NikolaiSte/CaNoRock/CaNoRock19 - English/Other documents/placement_and_orientation.jpg

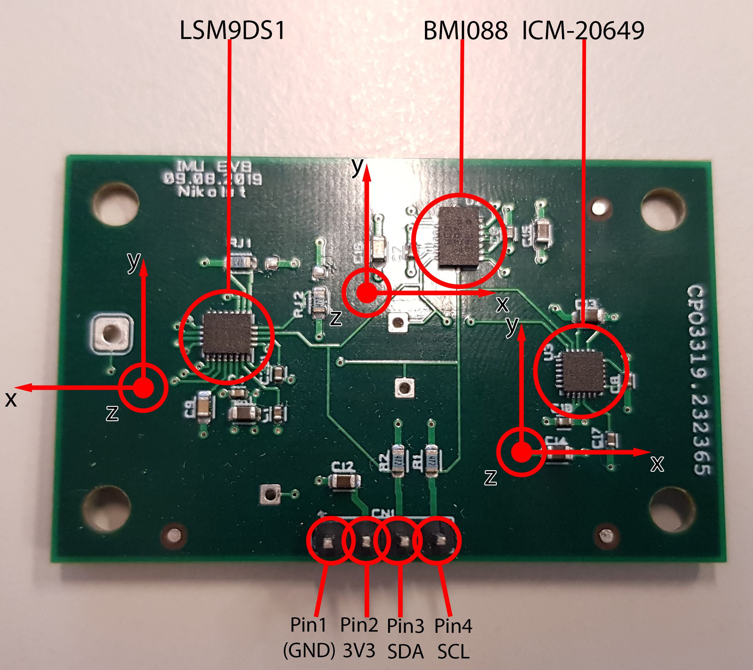
CaNoRock19 - English/Other documents/placement_and_orientation.jpg
