NikolaiSte/CaNoRock/CaNoRock19 - English/Arduino library files/README.txt

These folders need to be added to the correct folder in windows. If you have a general install of arduino, this would be
	C:\Users\xxxx\Documents\Arduino\libraries

This is because the header-files and their accompanying c++ files describing the function of each sensor are slightly modified
for the PCB-layout.
