NikolaiSte/CaNoRock/CaNoRock19 - English/Arduino library files/ICM20649/readme.md

# InvenSense 6-axis Accelerometer and Gyroscope(ICM20649)

## Usage
```
1. Git clone this repository to your Arduino IDE's libraries directory.
2. Run the demo "icm20649_example" in the examples directory.
```

This software is written by Ketil Røed and is licensed under [The MIT License](http://opensource.org/licenses/mit-license.php)

## Features

## Resources

- [Datasheet](http://www.invensense.com/wp-content/uploads/2016/06/DS-000192-ICM-20649-v1.0.pdf)
- [Evaluation board](https://no.mouser.com/datasheet/2/400/AN-IVS-0001EVB-00%20v1%202-1112214.pdf)
