NikolaiSte/CaNoRock/MainTM/Acceleration_X_MainTM.png

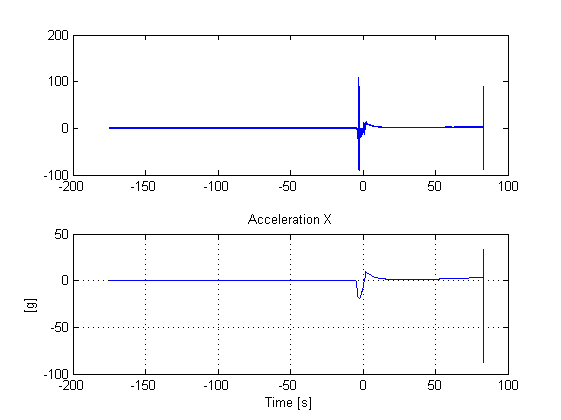
MainTM/Acceleration_X_MainTM.png
