NikolaiSte/CaNoRock/MainTM/Acceleration_Y_MainTM.png

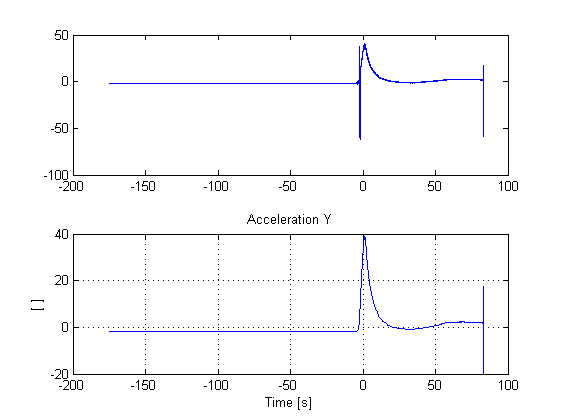
MainTM/Acceleration_Y_MainTM.png
