NikolaiSte/CaNoRock/MainTM/Battery_Voltage_MainTM.png

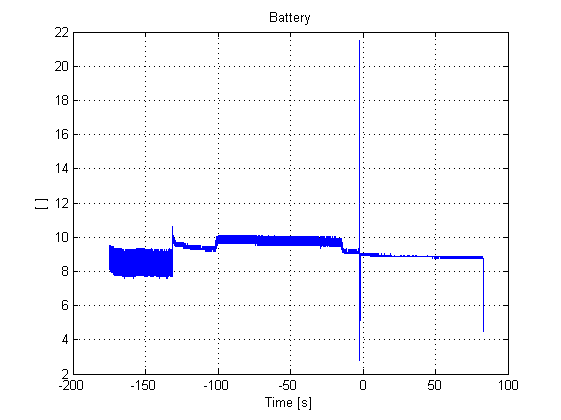
MainTM/Battery_Voltage_MainTM.png
