NikolaiSte/CaNoRock/MainTM/External_Temperature_MainTM.png

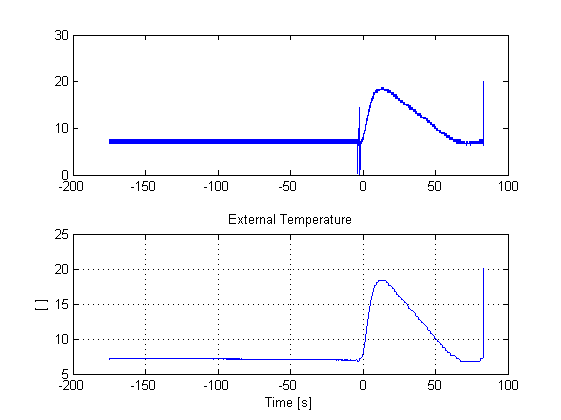
MainTM/External_Temperature_MainTM.png
