NikolaiSte/CaNoRock/MainTM/Framecounter_MainTM.png

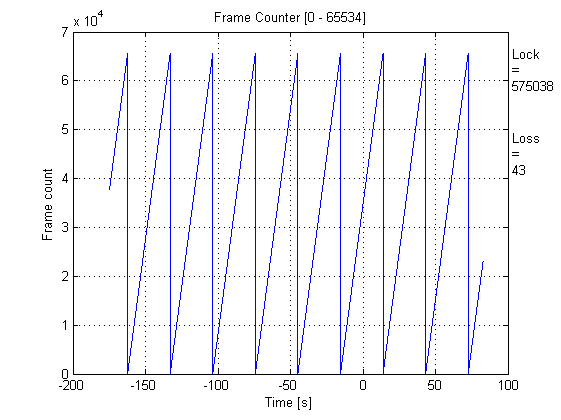
MainTM/Framecounter_MainTM.png
