NikolaiSte/CaNoRock/MainTM/Internal_Temperature_MainTM.png

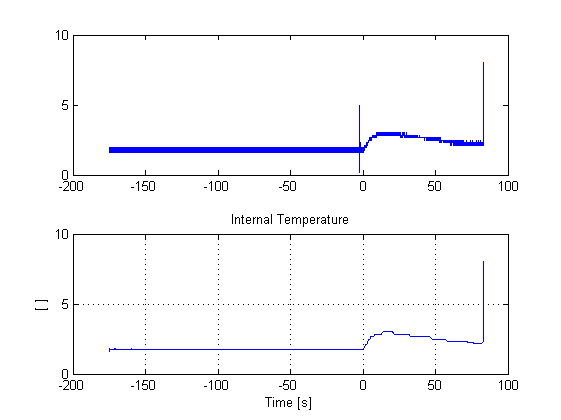
MainTM/Internal_Temperature_MainTM.png
