NikolaiSte/CaNoRock/MainTM/Light_MainTM.png

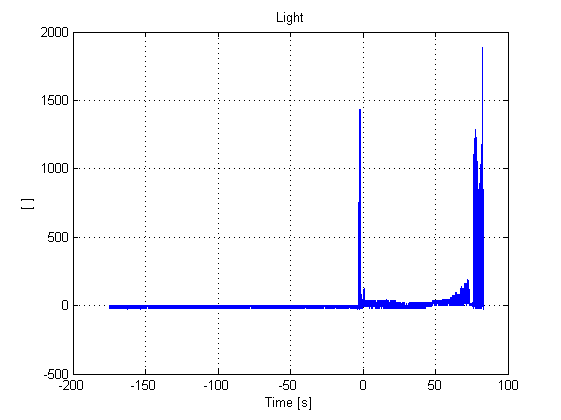
MainTM/Light_MainTM.png
