NikolaiSte/CaNoRock/MainTM/Magnetic_Field_MainTM.png

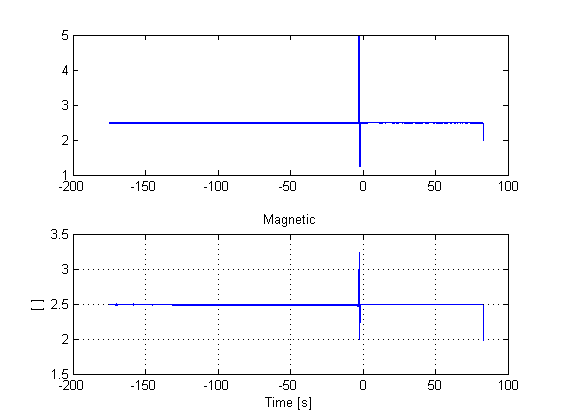
MainTM/Magnetic_Field_MainTM.png
