NikolaiSte/CaNoRock/MainTM/Pressure_MainTM.png

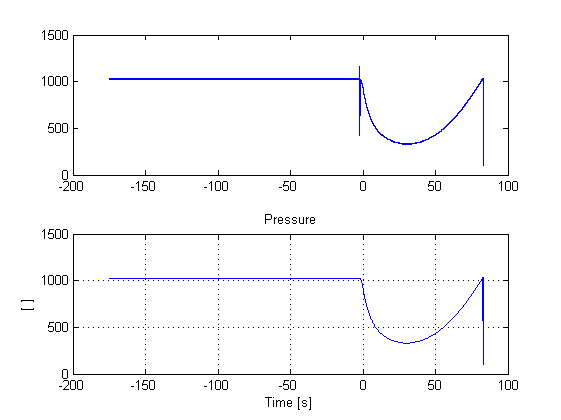
MainTM/Pressure_MainTM.png
