NikolaiSte/CaNoRock/MainTM/Temperature_Array_MainTM.png

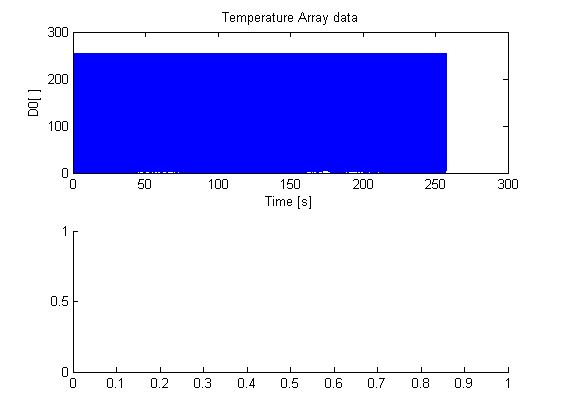
MainTM/Temperature_Array_MainTM.png
