NikolaiSte/CaNoRock/CaNoRock19 - English/Other documents/CAD-files/EVB_v1_6_fin_top_assembly.pdf

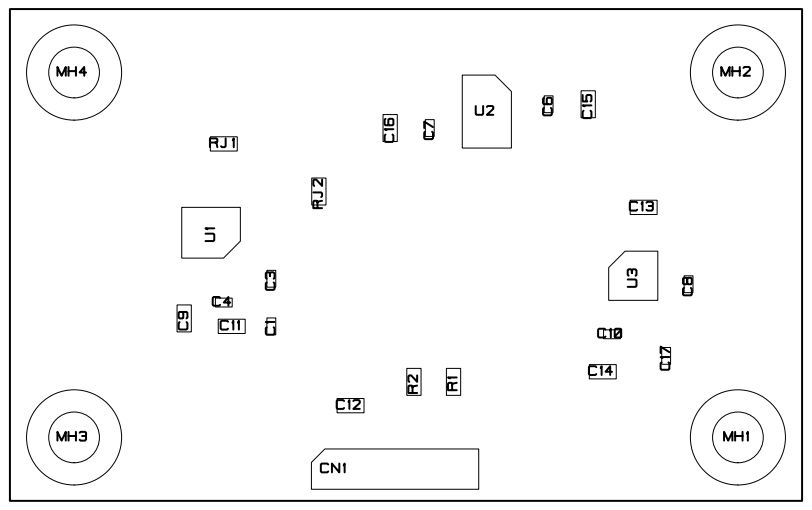
[picture p39: page 1]
