NikolaiSte/CaNoRock/CaNoRock19 - English/Other documents/CAD-files/EVB_sch_v1.pdf

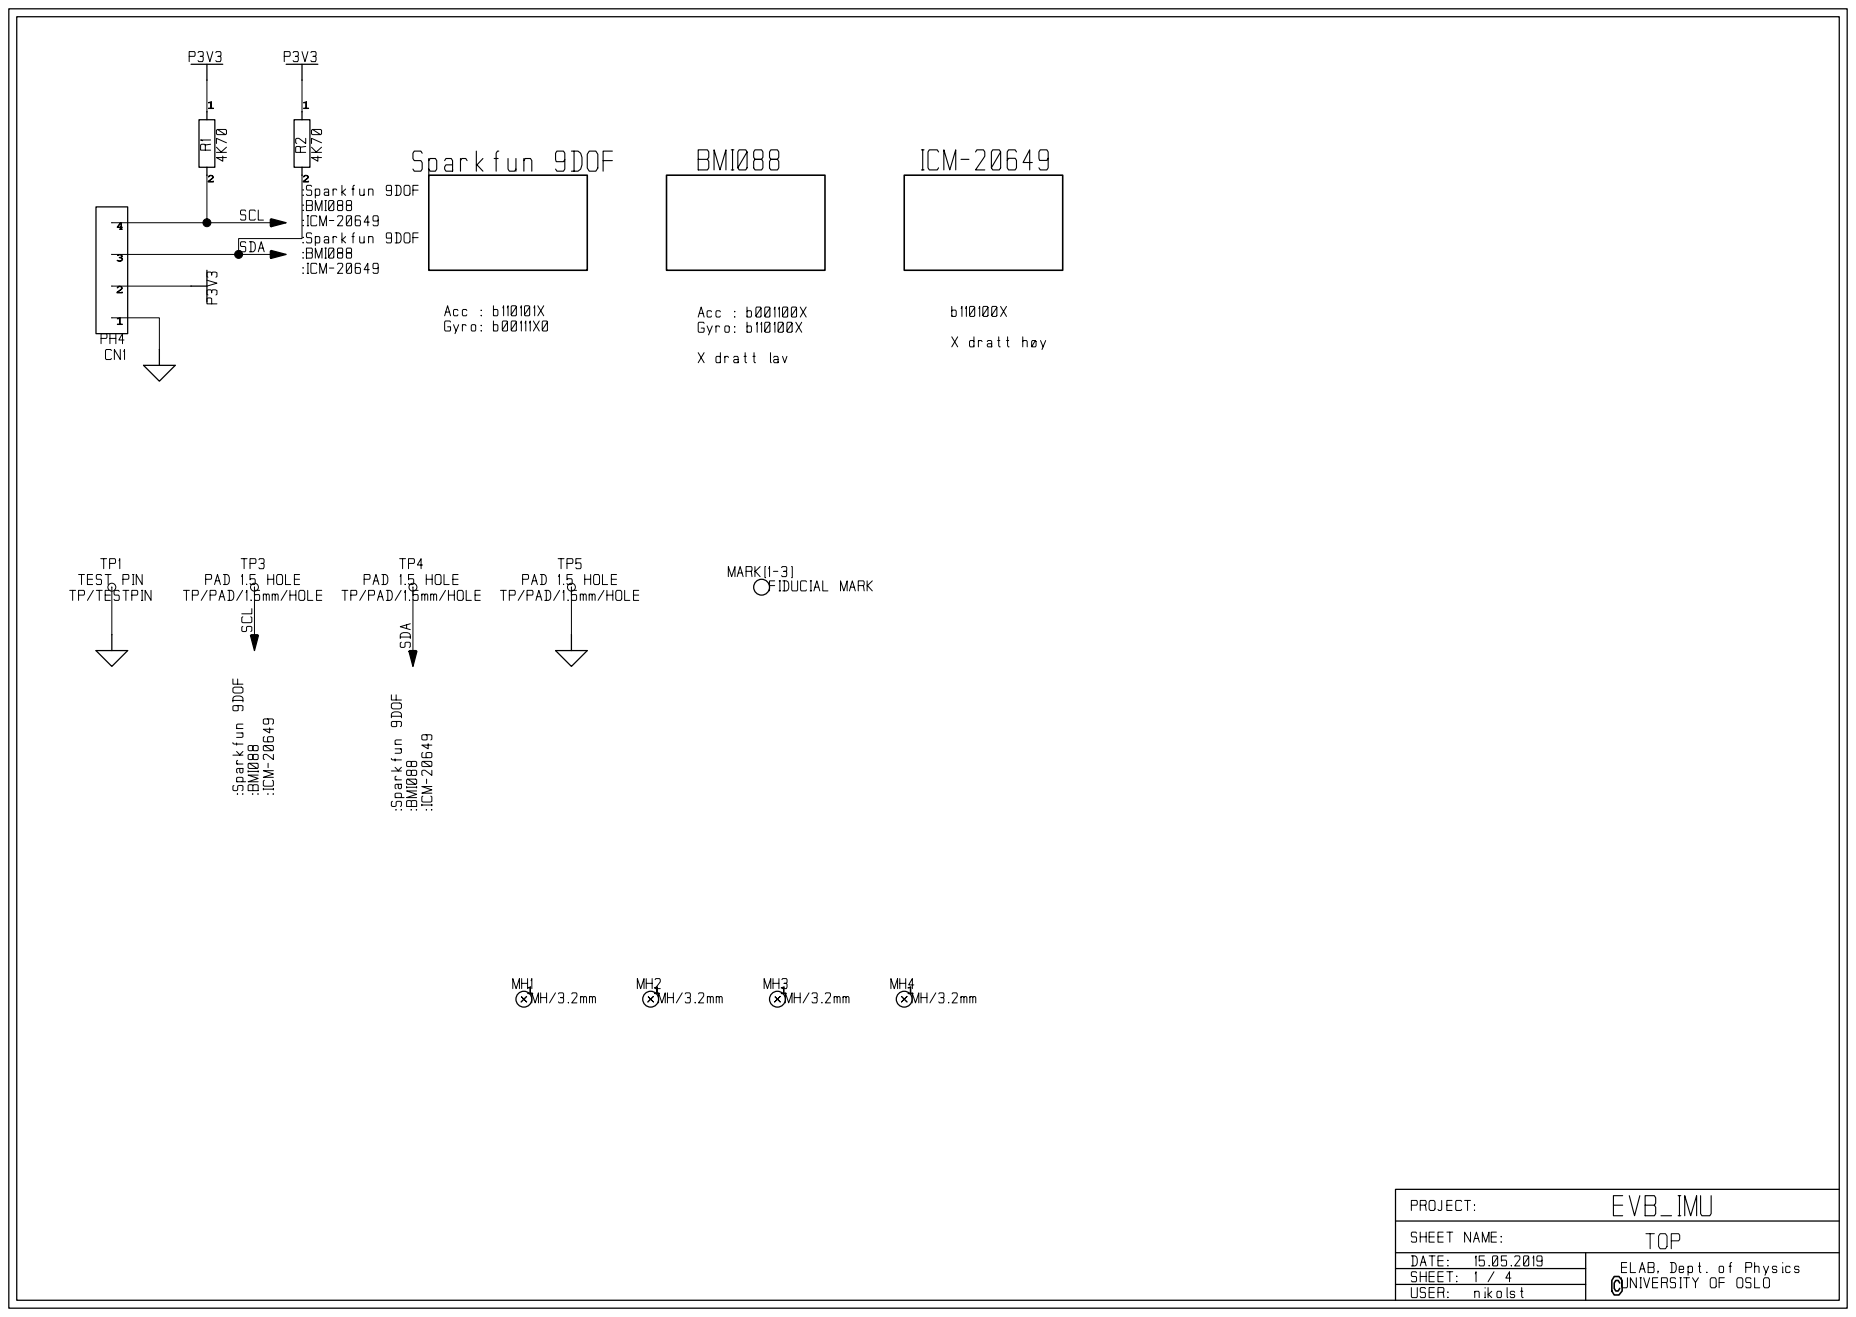
[picture p40: page 1]

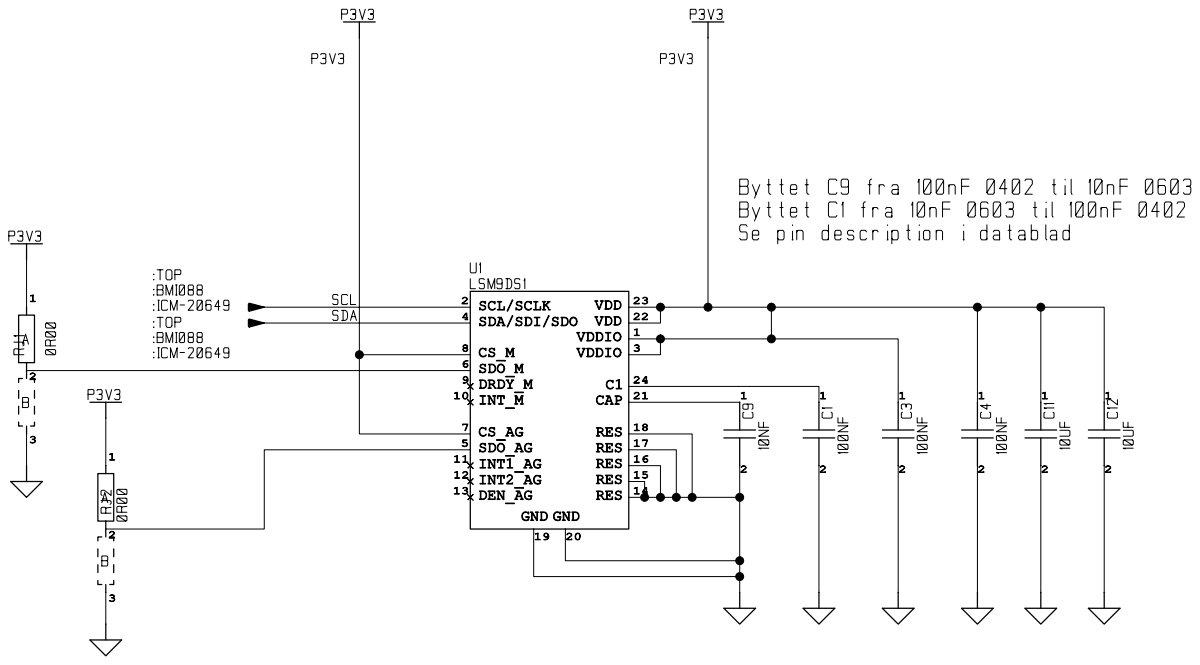
[picture p41: page 2]

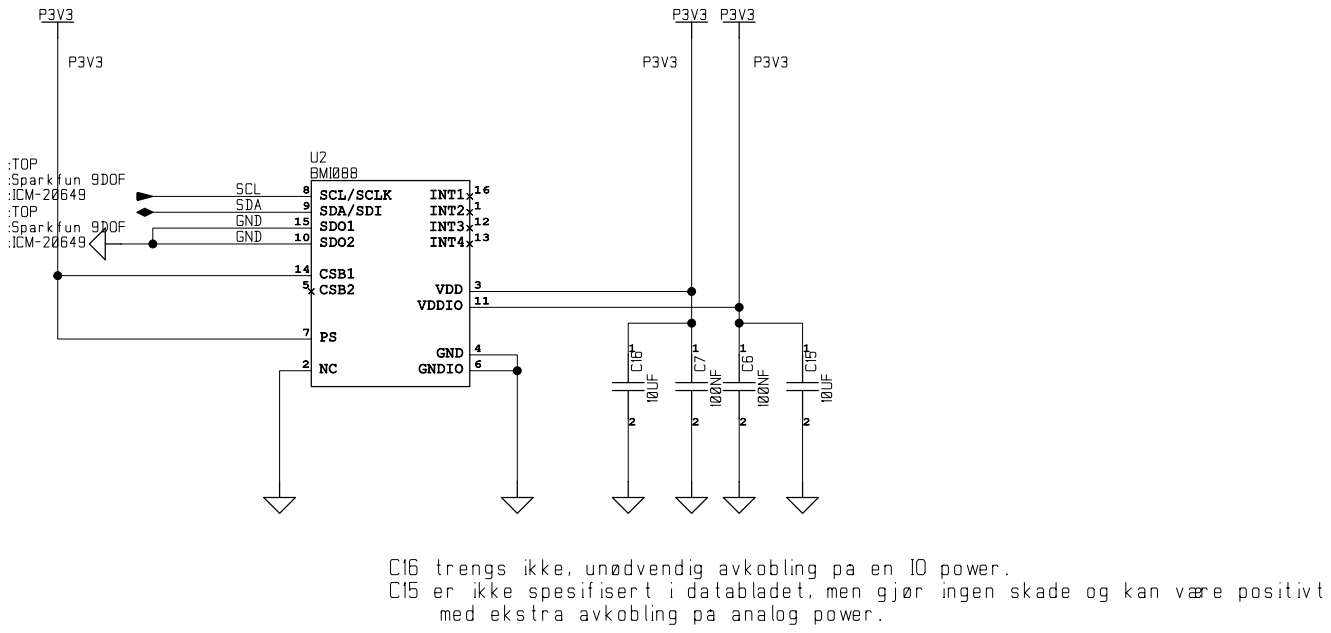
[picture p42: page 3]

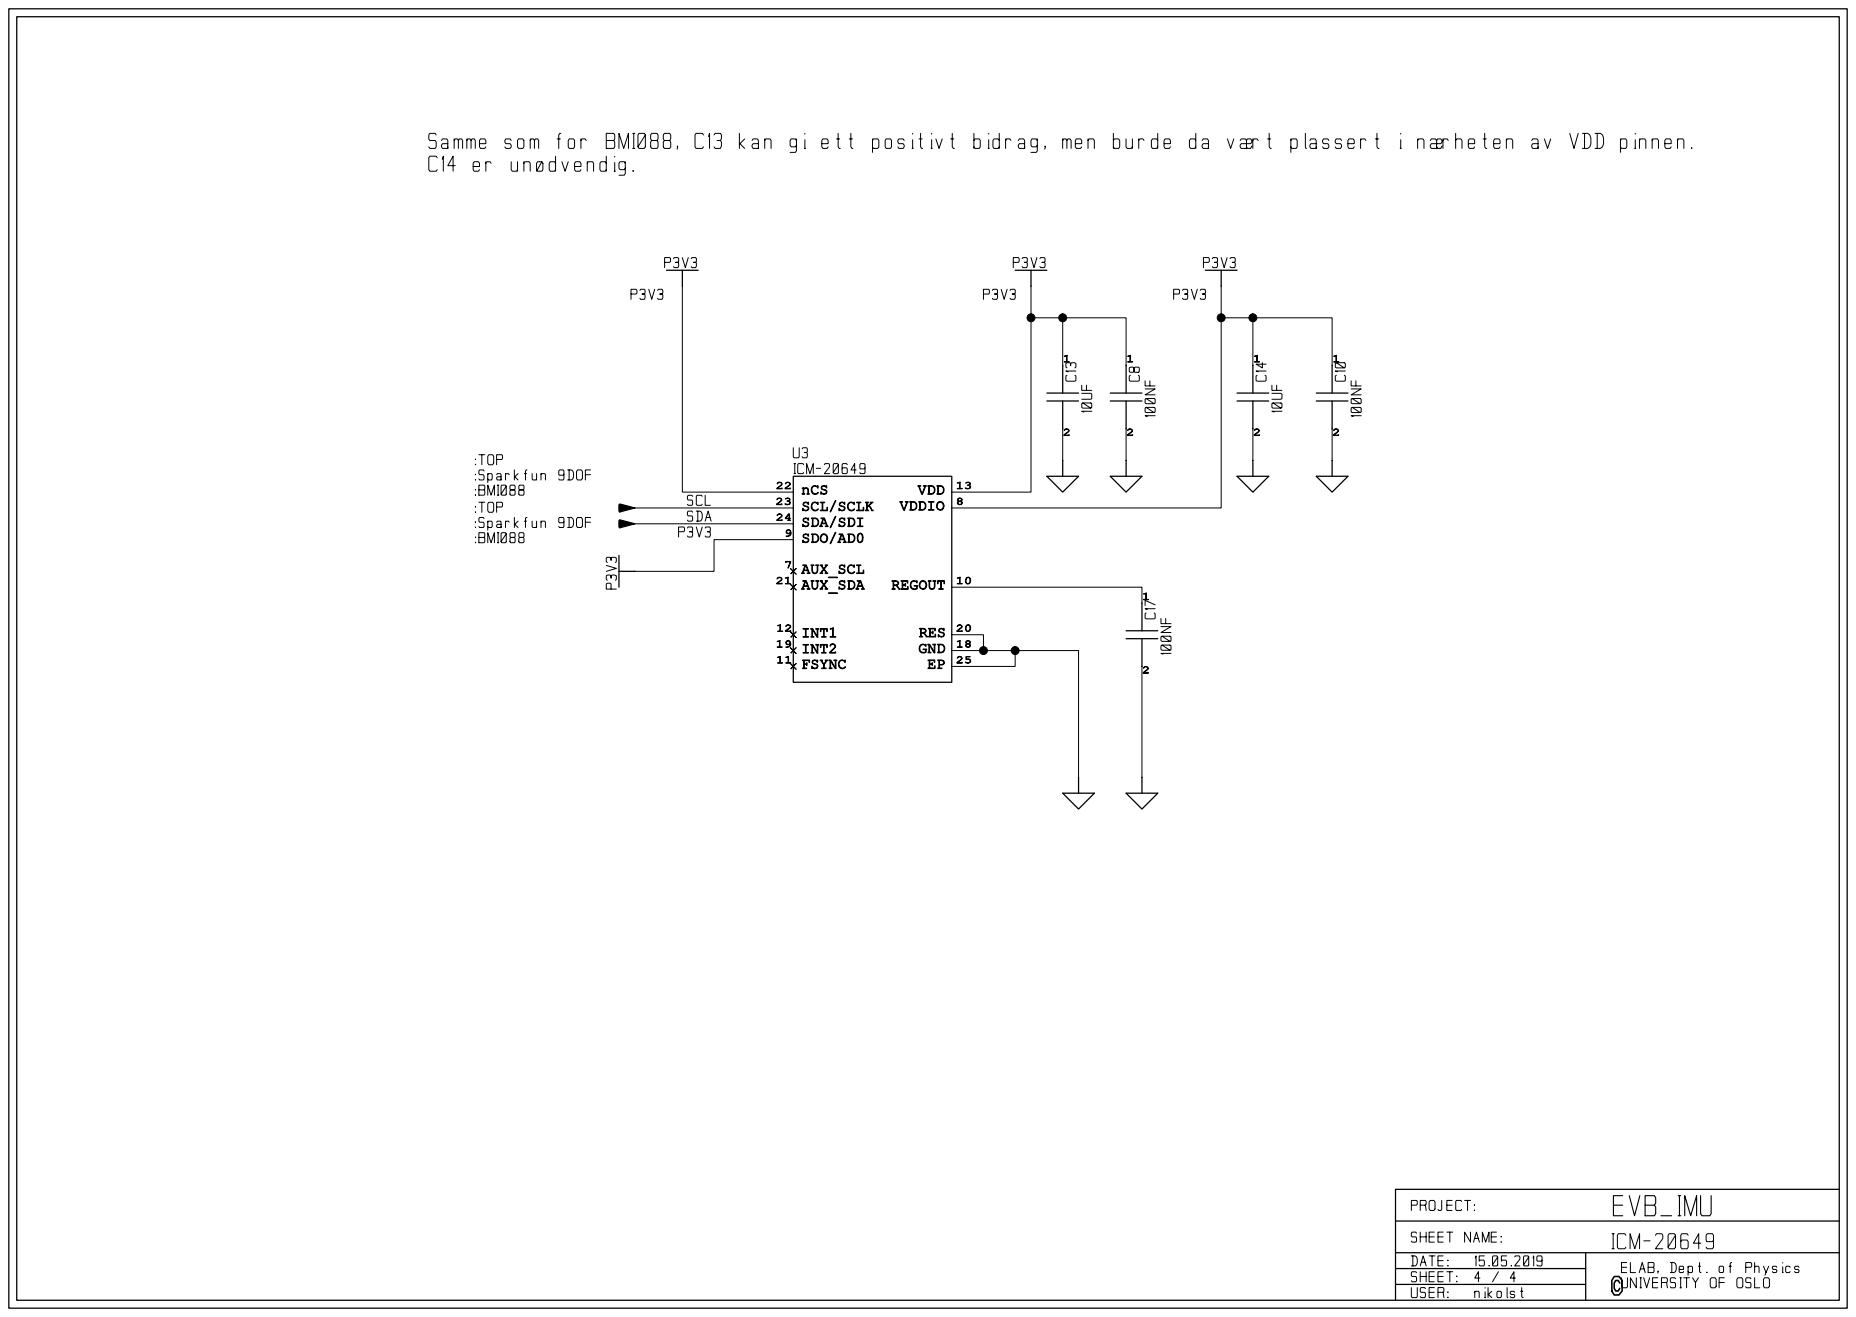
[picture p43: page 4]
