NikolaiSte/CaNoRock/CaNoRock19 - English/Other documents/CAD-files/EVB_v1_6_fin.pdf

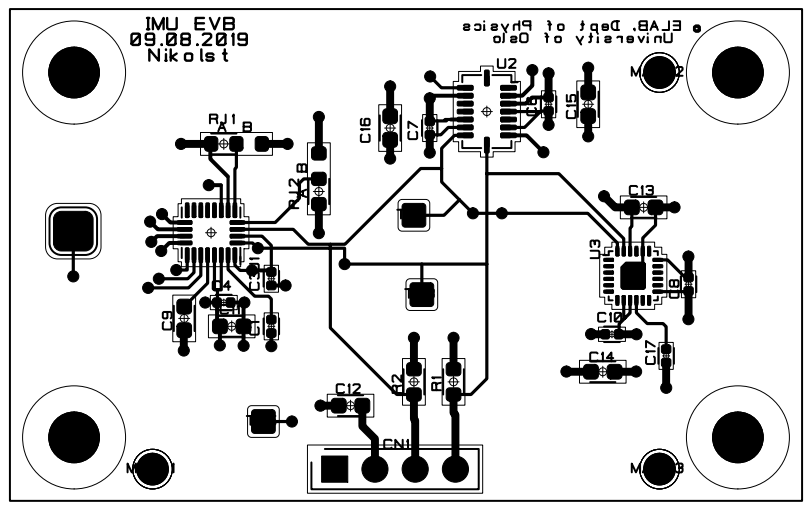
[picture p44: page 1]
