NikolaiSte/CaNoRock/CaNoRock19 - English/Other documents/CAD-files/EVB_v1_6_fin_top_cleanup.pdf

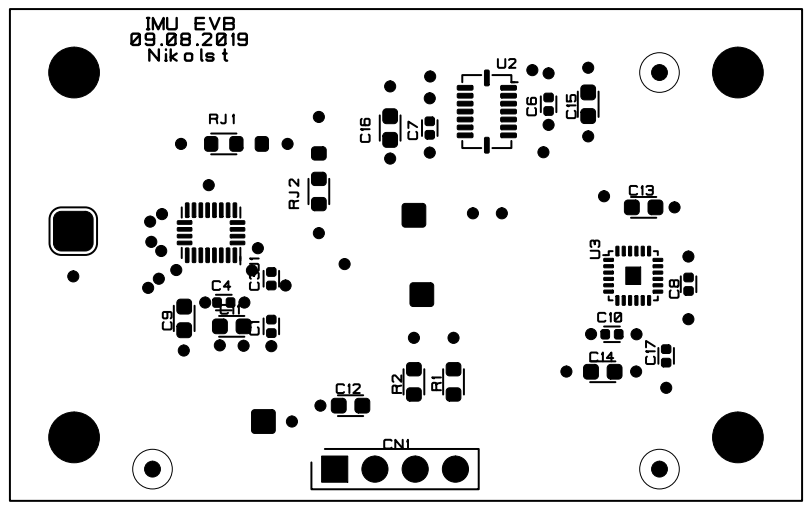
[picture p45: page 1]
