NikolaiSte/CaNoRock/CaNoRock19 - English/Other documents/CAD-files/EVB_v1_6_fin_top_place.pdf

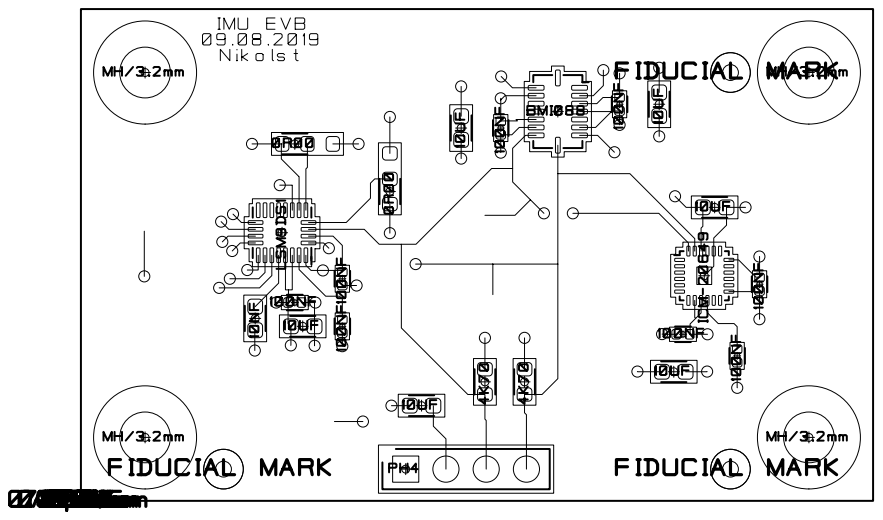
[picture p46: page 1]
