NikolaiSte/CaNoRock/(list of files, drawings)

Other design files:
CaNoRock19 - English/Other documents/CAD-files/EVB_v1_6_fin.pcb
