NikolaiSte/CaNoRock/(commit log)

2019-10-07 Add files via upload
    Final version flown during CaNoRock XVIII
2020-01-25 Files outlining and explaining setup
    [EVB_v1_6_fin.pcb]
